McMaster-Rocketry-Team/VLF5/pcb/VLF5.kicad_pcb

## KiCad design pcb/VLF5.kicad_pcb (2025-04-10)

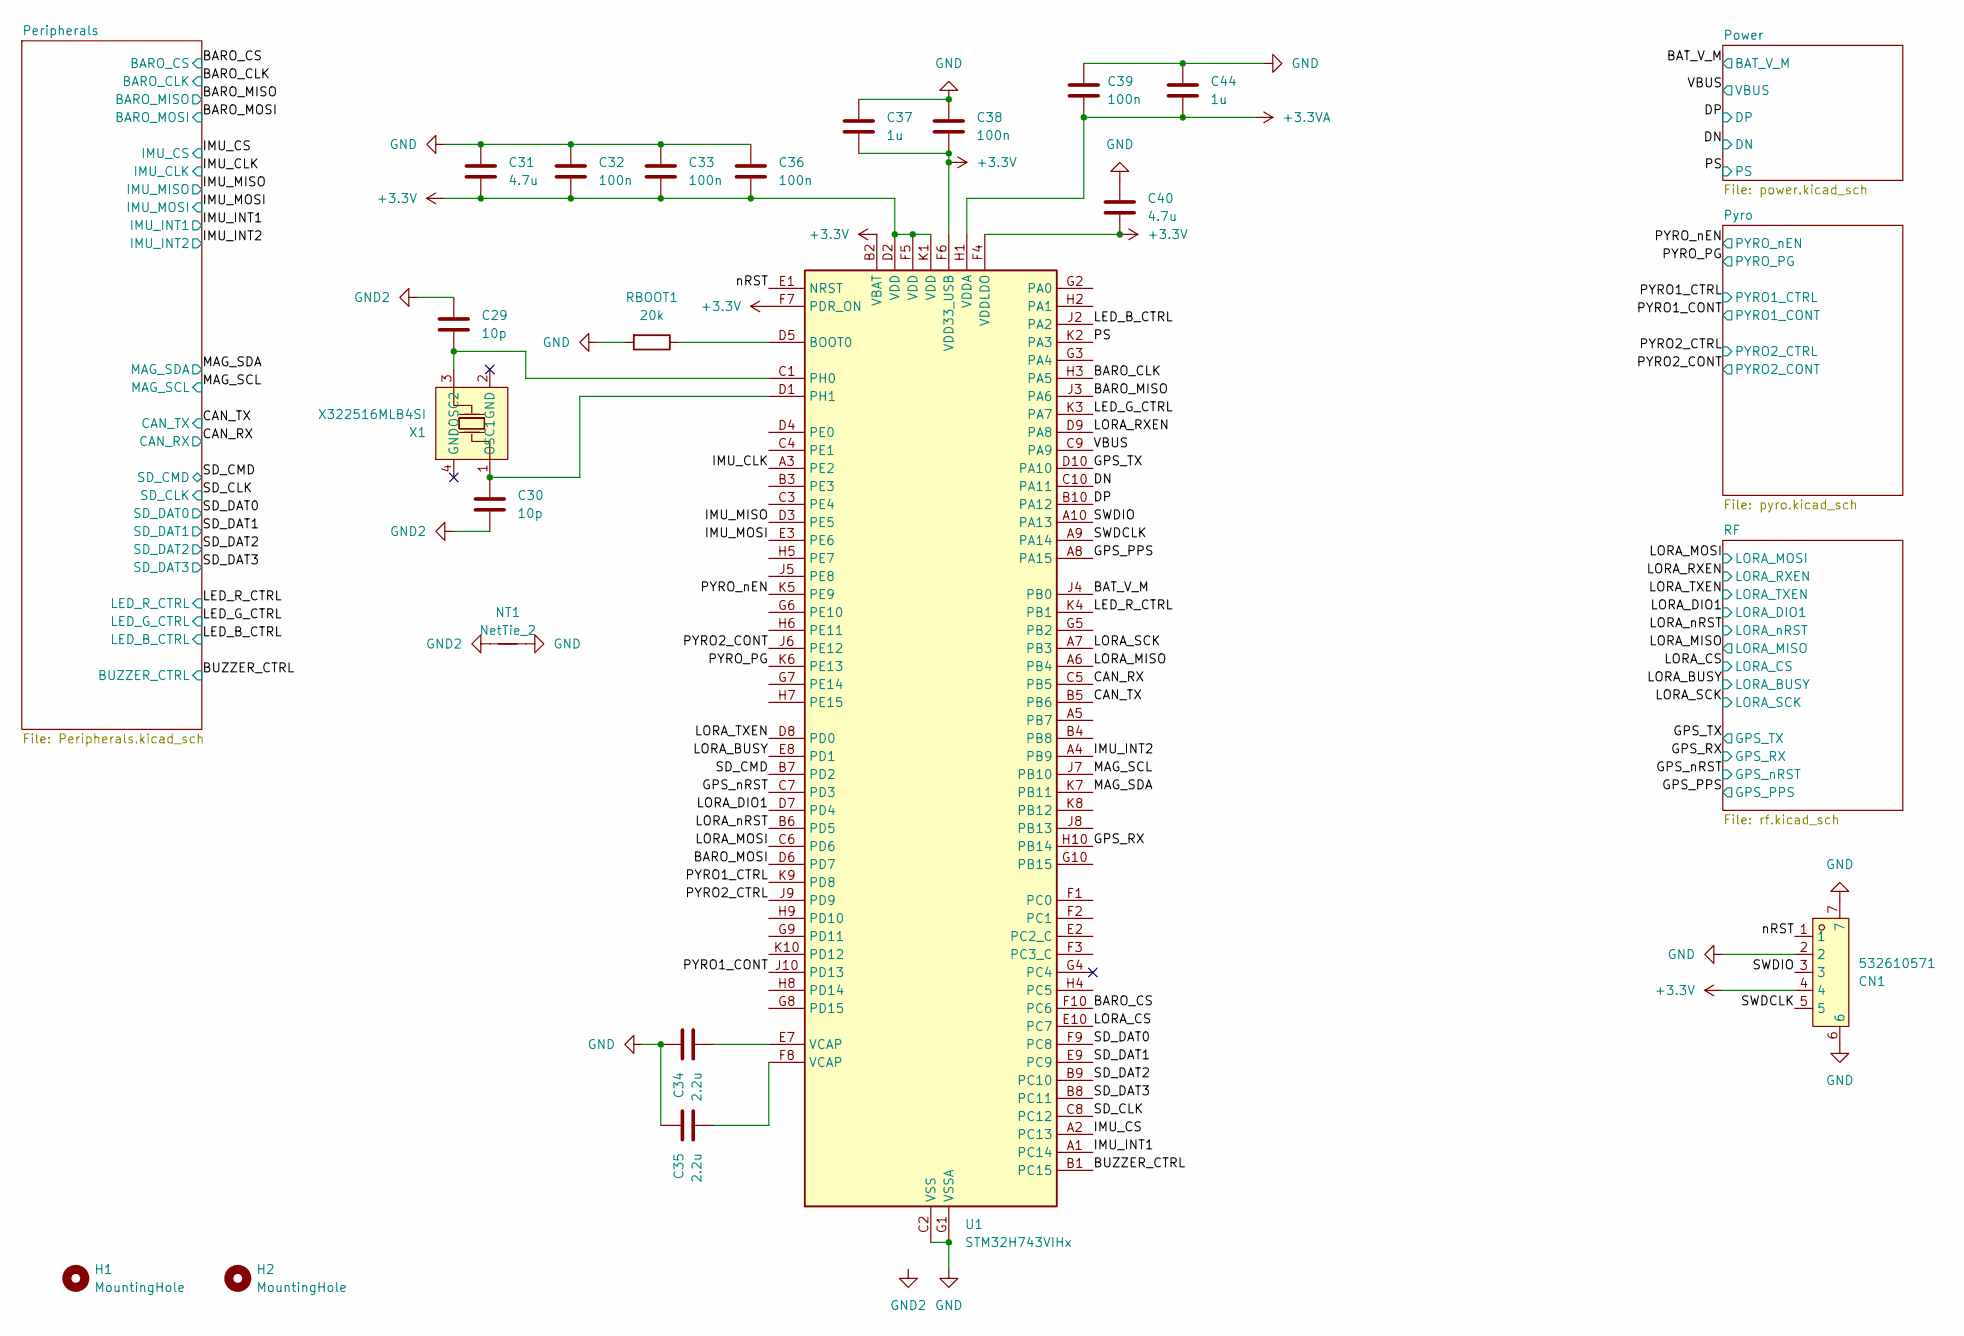
[picture p1: schematic VLF5.kicad_sch]

Parts:
C29, C30: 10p; C_0402_1005Metric
C31, C40: 4.7u; C_0402_1005Metric
C32, C33, C36, C38, C39: 100n; C_0402_1005Metric
C34, C35: 2.2u; C_0402_1005Metric
C37, C44: 1u; C_0402_1005Metric
CN1: 532610571; CONN-SMD_5P-P1.25_532610571-2; LCSC Part C392176
H1, H2: MountingHole; MountingHole_2.7mm_M2.5
NT1: NetTie_2; NetTie-2_SMD_Pad0.5mm
RBOOT1: 20k; R_0402_1005Metric
U1: STM32H743VIHx; TFBGA-100_8x8mm_Layout10x10_P0.8mm
X1: X322516MLB4SI; OSC-SMD_4P-L3.2-W2.5-BL; LCSC Part C13738

Connections:
+3.3V: C31.2, C32.2, C33.2, C36.2, C37.2, C38.2, C40.2, CN1.4, U1.B2 (VBAT), U1.D2 (VDD), U1.F4 (VDDLDO), U1.F5 (VDD), U1.F6 (VDD33_USB), U1.F7 (PDR_ON), U1.K1 (VDD); also elsewhere on the board
+3.3VA: C39.2, C44.2, U1.H1 (VDDA); also elsewhere on the board
/BARO_CLK: U1.H3 (PA5); also elsewhere on the board
/BARO_CS: U1.F10 (PC6); also elsewhere on the board
/BARO_MISO: U1.J3 (PA6); also elsewhere on the board
/BARO_MOSI: U1.D6 (PD7); also elsewhere on the board
/BAT_V_M: U1.J4 (PB0); also elsewhere on the board
/BUZZER_CTRL: U1.B1 (PC15); also elsewhere on the board
/CAN_RX: U1.C5 (PB5); also elsewhere on the board
/CAN_TX: U1.B5 (PB6); also elsewhere on the board
/DN: U1.C10 (PA11); also elsewhere on the board
/DP: U1.B10 (PA12); also elsewhere on the board
/GPS_PPS: U1.A8 (PA15); also elsewhere on the board
/GPS_RX: U1.H10 (PB14); also elsewhere on the board
/GPS_TX: U1.D10 (PA10); also elsewhere on the board
/GPS_nRST: U1.C7 (PD3); also elsewhere on the board
/IMU_CLK: U1.A3 (PE2); also elsewhere on the board
/IMU_CS: U1.A2 (PC13); also elsewhere on the board
/IMU_INT1: U1.A1 (PC14); also elsewhere on the board
/IMU_INT2: U1.A4 (PB9); also elsewhere on the board
/IMU_MISO: U1.D3 (PE5); also elsewhere on the board
/IMU_MOSI: U1.E3 (PE6); also elsewhere on the board
/LED_B_CTRL: U1.J2 (PA2); also elsewhere on the board
/LED_G_CTRL: U1.K3 (PA7); also elsewhere on the board
/LED_R_CTRL: U1.K4 (PB1); also elsewhere on the board
/LORA_BUSY: U1.E8 (PD1); also elsewhere on the board
/LORA_CS: U1.E10 (PC7); also elsewhere on the board
/LORA_DIO1: U1.D7 (PD4); also elsewhere on the board
/LORA_MISO: U1.A6 (PB4); also elsewhere on the board
/LORA_MOSI: U1.C6 (PD6); also elsewhere on the board
/LORA_RXEN: U1.D9 (PA8); also elsewhere on the board
/LORA_SCK: U1.A7 (PB3); also elsewhere on the board
/LORA_TXEN: U1.D8 (PD0); also elsewhere on the board
/LORA_nRST: U1.B6 (PD5); also elsewhere on the board
/MAG_SCL: U1.J7 (PB10); also elsewhere on the board
/MAG_SDA: U1.K7 (PB11); also elsewhere on the board
/PS: U1.K2 (PA3); also elsewhere on the board
/PYRO1_CONT: U1.J10 (PD13); also elsewhere on the board
/PYRO1_CTRL: U1.K9 (PD8); also elsewhere on the board
/PYRO2_CONT: U1.J6 (PE12); also elsewhere on the board
/PYRO2_CTRL: U1.J9 (PD9); also elsewhere on the board
/PYRO_PG: U1.K6 (PE13); also elsewhere on the board
/PYRO_nEN: U1.K5 (PE9); also elsewhere on the board
/SD_CLK: U1.C8 (PC12); also elsewhere on the board
/SD_CMD: U1.B7 (PD2); also elsewhere on the board
/SD_DAT0: U1.F9 (PC8); also elsewhere on the board
/SD_DAT1: U1.E9 (PC9); also elsewhere on the board
/SD_DAT2: U1.B9 (PC10); also elsewhere on the board
/SD_DAT3: U1.B8 (PC11); also elsewhere on the board
/SWDCLK: CN1.5, U1.A9 (PA14)
/SWDIO: CN1.3, U1.A10 (PA13)
/VBUS: U1.C9 (PA9); also elsewhere on the board
/nRST: CN1.1, U1.E1 (NRST)
unnamed: C34.2, U1.E7 (VCAP)
unnamed: C35.2, U1.F8 (VCAP)
unnamed: RBOOT1.1, U1.D5 (BOOT0)
unnamed: C29.2, U1.C1 (PH0), X1.3 (OSC2)
unnamed: C30.1, U1.D1 (PH1), X1.1 (OSC1)

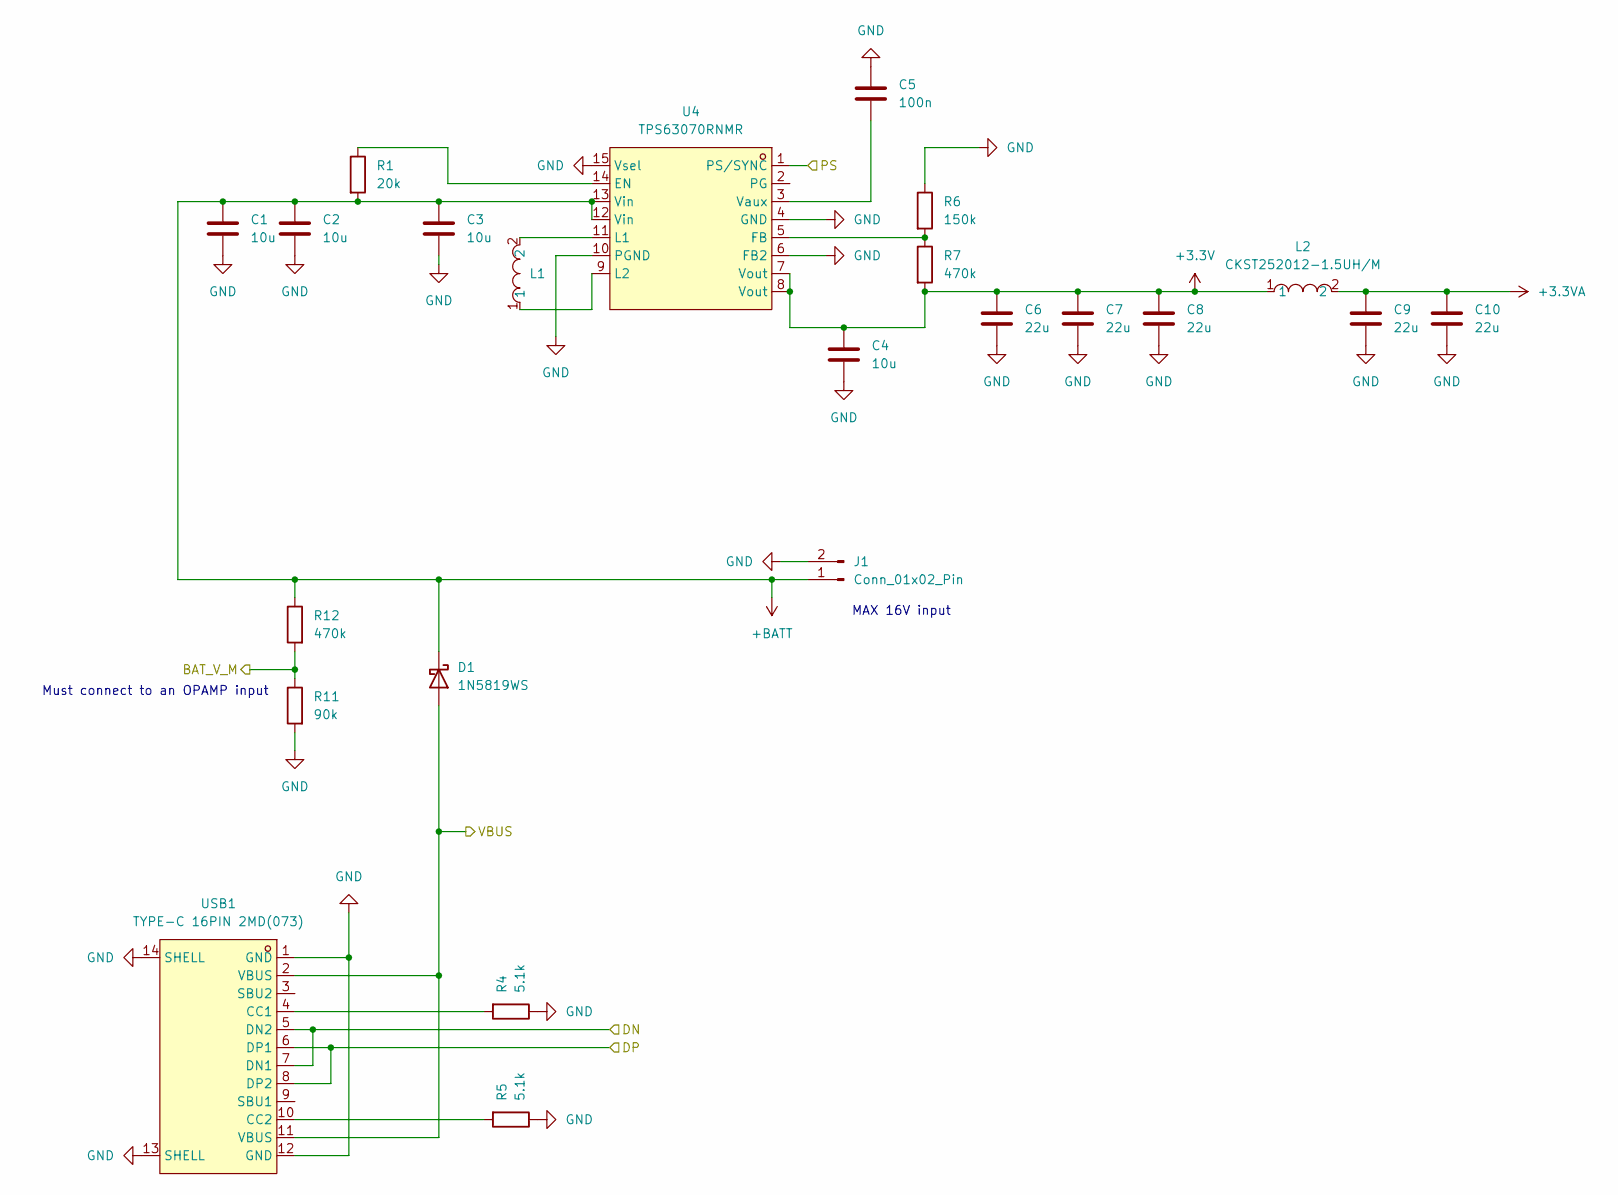
[picture p2: schematic power.kicad_sch]

Parts:
C1, C2, C3, C4: 10u; C_0603_1608Metric
C5: 100n; C_0402_1005Metric
C6, C7, C8, C9, C10: 22u; C_0603_1608Metric
D1: 1N5819WS; D_SOD-323
J1: Conn_01x02_Pin; 1054301102
L1, L2: CKST252012-1.5UH/M; IND-SMD_L2.5-W2.0-VLS252012CX-150M; LCSC Part C3002550
R1: 20k; R_0402_1005Metric
R4, R5: 5.1k; R_0402_1005Metric
R6: 150k; R_0402_1005Metric
R7, R12: 470k; R_0402_1005Metric
R11: 90k; R_0402_1005Metric
U4: TPS63070RNMR; VQFN-HR-15_L3.0-W2.5-P0.50-BL_TPS63070RNMR; LCSC Part C109322
USB1: TYPE-C 16PIN 2MD(073); USB-C-SMD_TYPE-C-6PIN-2MD-073; LCSC Part C2765186

Connections:
+3.3V: C4.2, C6.2, C7.2, C8.2, L2.1, R7.2, U4.7 (Vout), U4.8 (Vout); also elsewhere on the board
+3.3VA: C9.2, C10.2, L2.2; also elsewhere on the board
+BATT: C1.2, C2.2, C3.2, D1.1 (K), J1.1, J1.S2, R1.2, R12.1, U4.12 (Vin), U4.13 (Vin); also elsewhere on the board
/BAT_V_M: R11.1, R12.2; also elsewhere on the board
/DN: USB1.5 (DN2), USB1.7 (DN1); also elsewhere on the board
/DP: USB1.6 (DP1), USB1.8 (DP2); also elsewhere on the board
/PS: U4.1 (PS/SYNC); also elsewhere on the board
/VBUS: D1.2 (A), USB1.2 (VBUS), USB1.11 (VBUS); also elsewhere on the board
unnamed: R1.1, U4.14 (EN)
unnamed: R6.2, R7.1, U4.5 (FB)
unnamed: L1.2, U4.11 (L1)
unnamed: L1.1, U4.9 (L2)
unnamed: C5.1, U4.3 (Vaux)
unnamed: R4.2, USB1.4 (CC1)
unnamed: R5.2, USB1.10 (CC2)

Notes on the sheet:
Must connect to an OPAMP input
MAX 16V input

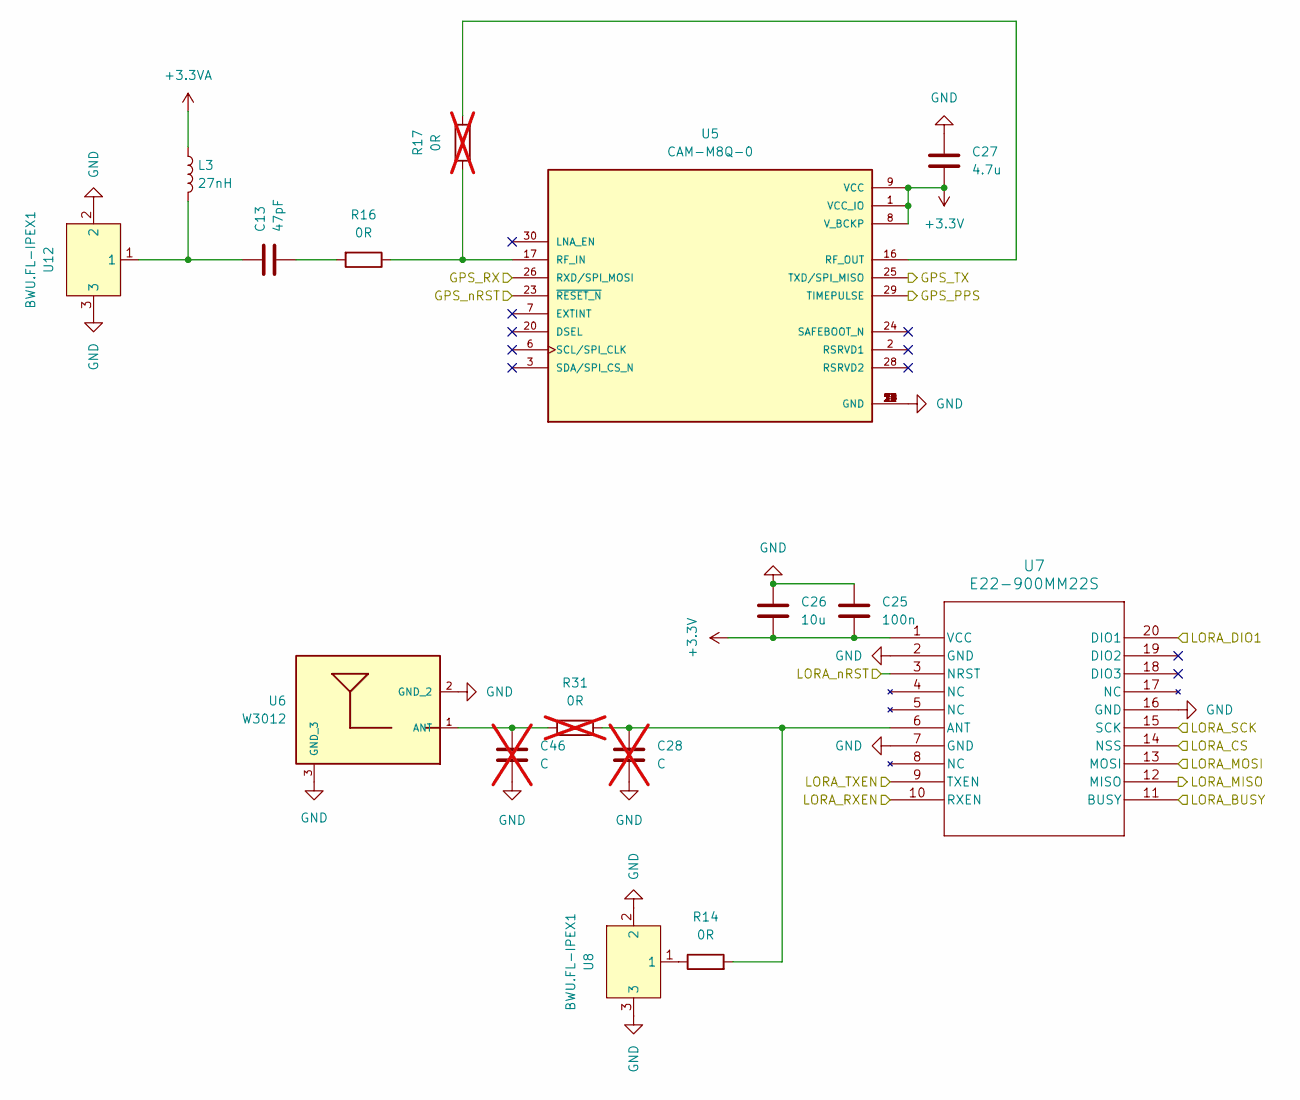
[picture p3: schematic rf.kicad_sch]

Parts:
C13: 47pF; C_0603_1608Metric_Pad1.08x0.95mm_HandSolder
C25: 100n; C_0402_1005Metric
C26: 10u; C_0603_1608Metric
C27: 4.7u; C_0402_1005Metric
C28, C46: C; C_0603_1608Metric_Pad1.08x0.95mm_HandSolder; not fitted
L3: 27nH; L_0603_1608Metric_Pad1.05x0.95mm_HandSolder
R14, R16: 0R; R_0603_1608Metric_Pad0.98x0.95mm_HandSolder
R17, R31: 0R; R_0603_1608Metric_Pad0.98x0.95mm_HandSolder; not fitted
U5: CAM-M8Q-0; LCC100P960X1400X210-31N
U6: W3012; W3012-ANT-PKG
U7: E22-900MM22S; E22-900MM22S_BYT
U8, U12: BWU.FL-IPEX1; IPEX-SMD_BWIPX-1-001E; LCSC Part C5137195

Connections:
+3.3V: C25.2, C26.2, C27.2, U5.1 (VCC_IO), U5.8 (V_BCKP), U5.9 (VCC), U7.1 (VCC); also elsewhere on the board
+3.3VA: L3.1; also elsewhere on the board
/GPS_PPS: U5.29 (TIMEPULSE); also elsewhere on the board
/GPS_RX: U5.26 (RXD/SPI_MOSI); also elsewhere on the board
/GPS_TX: U5.25 (TXD/SPI_MISO); also elsewhere on the board
/GPS_nRST: U5.23 (~RESET_N); also elsewhere on the board
/LORA_BUSY: U7.11 (BUSY); also elsewhere on the board
/LORA_CS: U7.14 (NSS); also elsewhere on the board
/LORA_DIO1: U7.20 (DIO1); also elsewhere on the board
/LORA_MISO: U7.12 (MISO); also elsewhere on the board
/LORA_MOSI: U7.13 (MOSI); also elsewhere on the board
/LORA_RXEN: U7.10 (RXEN); also elsewhere on the board
/LORA_SCK: U7.15 (SCK); also elsewhere on the board
/LORA_TXEN: U7.9 (TXEN); also elsewhere on the board
/LORA_nRST: U7.3 (NRST); also elsewhere on the board
unnamed: C13.1, L3.2, U12.1
unnamed: C13.2, R16.2
unnamed: R14.1, U8.1
unnamed: R16.1, R17.1, U5.17 (RF_IN)
unnamed: R17.2, U5.16 (RF_OUT)
unnamed: C46.1, R31.1, U6.1 (ANT)
unnamed: C28.1, R14.2, R31.2, U7.6 (ANT)

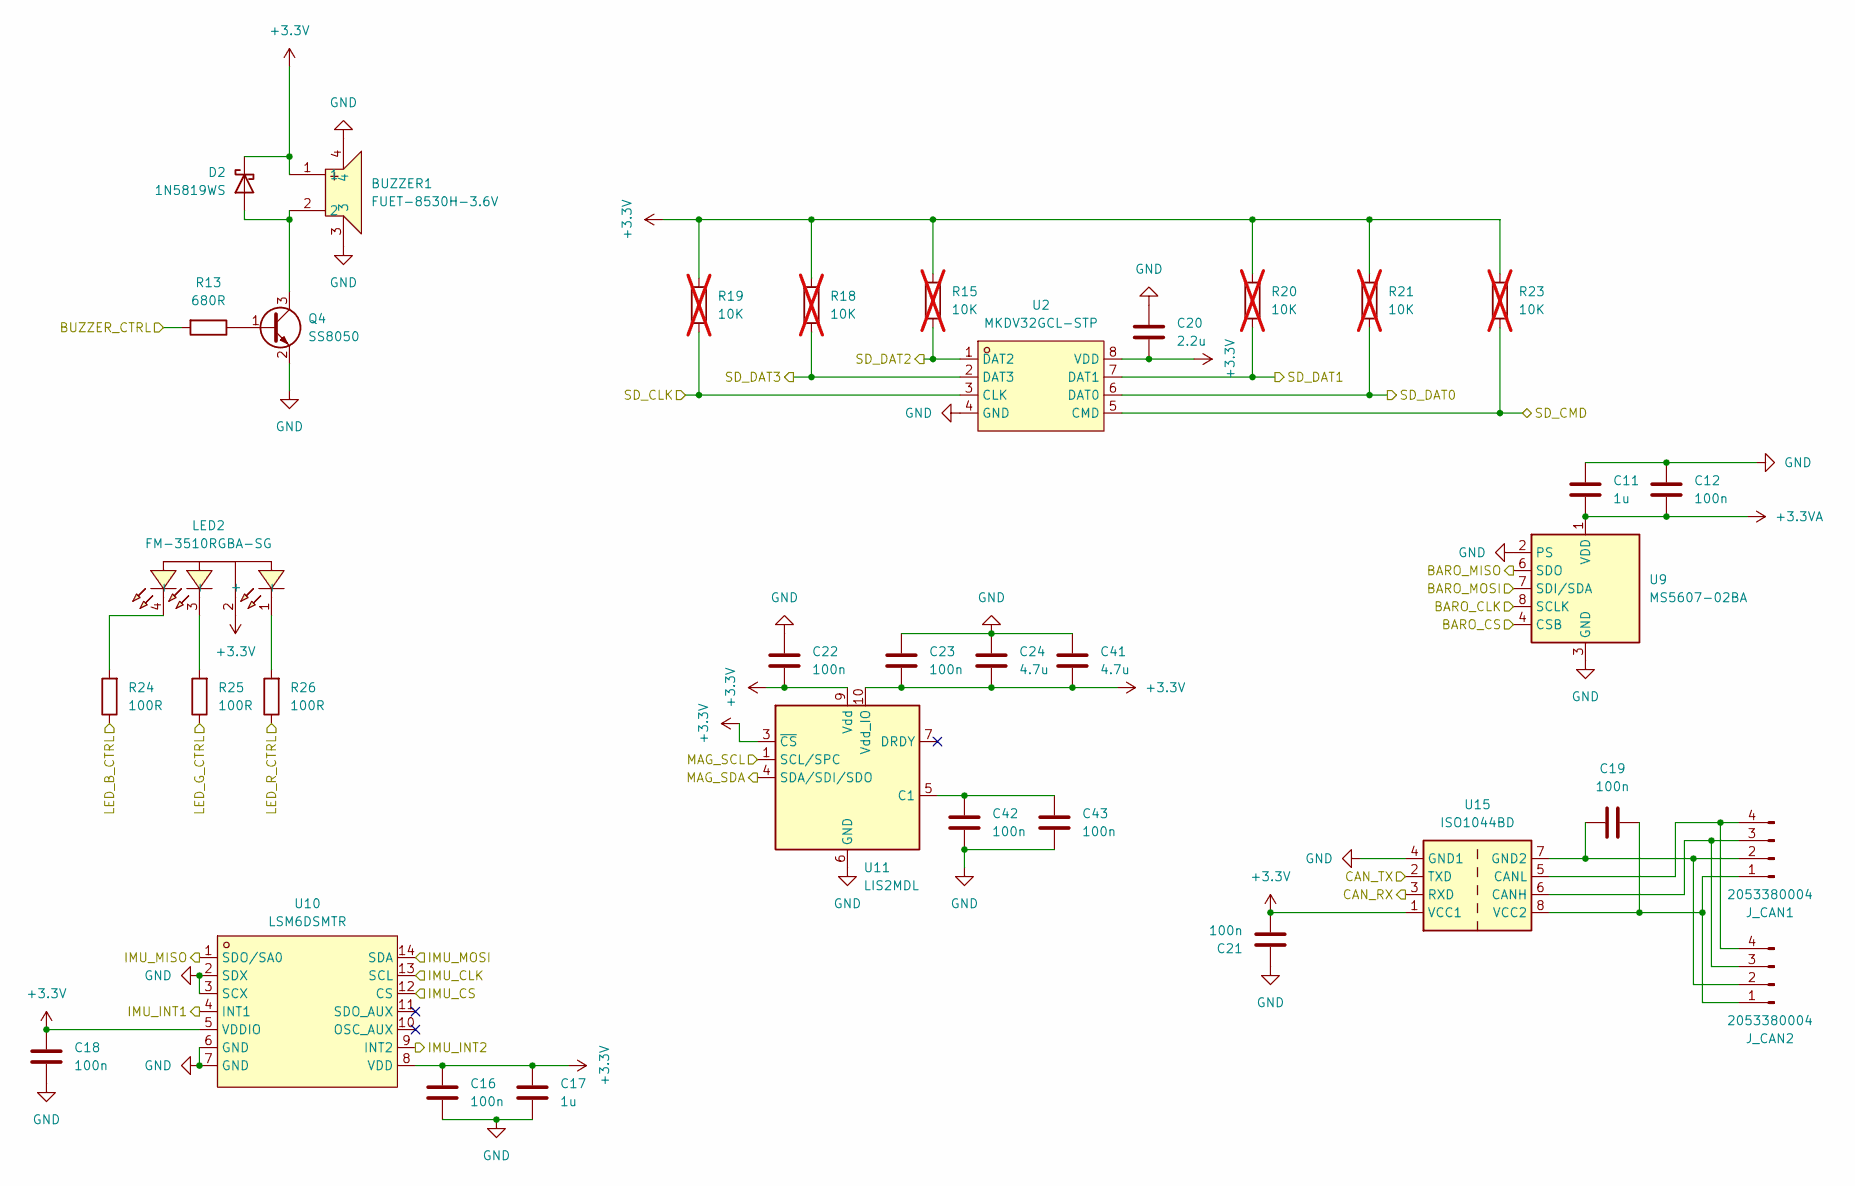
[picture p4: schematic Peripherals.kicad_sch]

Parts:
BUZZER1: FUET-8530H-3.6V; BUZ-SMD_4P-L8.5-W8.5_FUET-8530-05; LCSC Part C417429
C11, C17: 1u; C_0402_1005Metric
C12, C16, C18, C19, C21, C22, C23, C42, C43: 100n; C_0402_1005Metric
C20: 2.2u; C_0402_1005Metric
C24, C41: 4.7u; C_0402_1005Metric
D2: 1N5819WS; D_SOD-323
J_CAN1, J_CAN2: 2053380004; CONN_2053380000-SD_04_MOL
LED2: FM-3510RGBA-SG; LED-SMD_FM-3510RGBA-SG; LCSC Part C727903
Q4: SS8050; SOT-23
R13: 680R; R_0402_1005Metric
R15, R18, R19, R20, R21, R23: 10K; R_0603_1608Metric_Pad0.98x0.95mm_HandSolder; not fitted
R24, R25, R26: 100R; R_0402_1005Metric
U2: MKDV32GCL-STP; LGA-8_L6.0-W8.0-P1.27-TL; LCSC Part C7500179
U9: MS5607-02BA; LGA-8_3x5mm_P1.25mm
U10: LSM6DSMTR; LGA-14_L3.0-W2.5-P0.50-TL; LCSC Part C94048
U11: LIS2MDL; LGA-12_2x2mm_P0.5mm
U15: ISO1044BD; SOIC-8_3.9x4.9mm_P1.27mm

Connections:
+3.3V: BUZZER1.1, C16.1, C17.1, C18.1, C20.2, C21.2, C22.2, C23.2, C24.2, C41.2, D2.1 (K), LED2.2 (+), R15.2, R18.2, R19.2, R20.2, R21.2, R23.2, U2.8 (VDD), U10.5 (VDDIO), U10.8 (VDD), U11.3 (~CS), U11.9 (Vdd), U11.10 (Vdd_IO), U15.1 (VCC1); also elsewhere on the board
+3.3VA: C11.2, C12.2, U9.1 (VDD); also elsewhere on the board
/BARO_CLK: U9.8 (SCLK); also elsewhere on the board
/BARO_CS: U9.4 (CSB), U9.5 (CSB); also elsewhere on the board
/BARO_MISO: U9.6 (SDO); also elsewhere on the board
/BARO_MOSI: U9.7 (SDI/SDA); also elsewhere on the board
/BUZZER_CTRL: R13.2; also elsewhere on the board
/CAN_RX: U15.3 (RXD); also elsewhere on the board
/CAN_TX: U15.2 (TXD); also elsewhere on the board
/IMU_CLK: U10.13 (SCL); also elsewhere on the board
/IMU_CS: U10.12 (CS); also elsewhere on the board
/IMU_INT1: U10.4 (INT1); also elsewhere on the board
/IMU_INT2: U10.9 (INT2); also elsewhere on the board
/IMU_MISO: U10.1 (SDO/SA0); also elsewhere on the board
/IMU_MOSI: U10.14 (SDA); also elsewhere on the board
/LED_B_CTRL: R24.1; also elsewhere on the board
/LED_G_CTRL: R25.1; also elsewhere on the board
/LED_R_CTRL: R26.1; also elsewhere on the board
/MAG_SCL: U11.1 (SCL/SPC); also elsewhere on the board
/MAG_SDA: U11.4 (SDA/SDI/SDO); also elsewhere on the board
/SD_CLK: R19.1, U2.3 (CLK); also elsewhere on the board
/SD_CMD: R23.1, U2.5 (CMD); also elsewhere on the board
/SD_DAT0: R21.1, U2.6 (DAT0); also elsewhere on the board
/SD_DAT1: R20.1, U2.7 (DAT1); also elsewhere on the board
/SD_DAT2: R15.1, U2.1 (DAT2); also elsewhere on the board
/SD_DAT3: R18.1, U2.2 (DAT3); also elsewhere on the board
unnamed: BUZZER1.2, D2.2 (A), Q4.3 (C)
unnamed: C19.2, J_CAN1.1, J_CAN2.1, U15.8 (VCC2)
unnamed: C19.1, J_CAN1.2, J_CAN2.2, U15.7 (GND2)
unnamed: J_CAN1.3, J_CAN2.3, U15.6 (CANH)
unnamed: J_CAN1.4, J_CAN2.4, U15.5 (CANL)
unnamed 65: J_CAN1.6, J_CAN2.5; also elsewhere on the board
unnamed: LED2.1 (-), R26.2
unnamed: LED2.3 (-), R25.2
unnamed: LED2.4 (-), R24.2
unnamed: Q4.1 (B), R13.1
unnamed: C42.1, C43.1, U11.5 (C1)

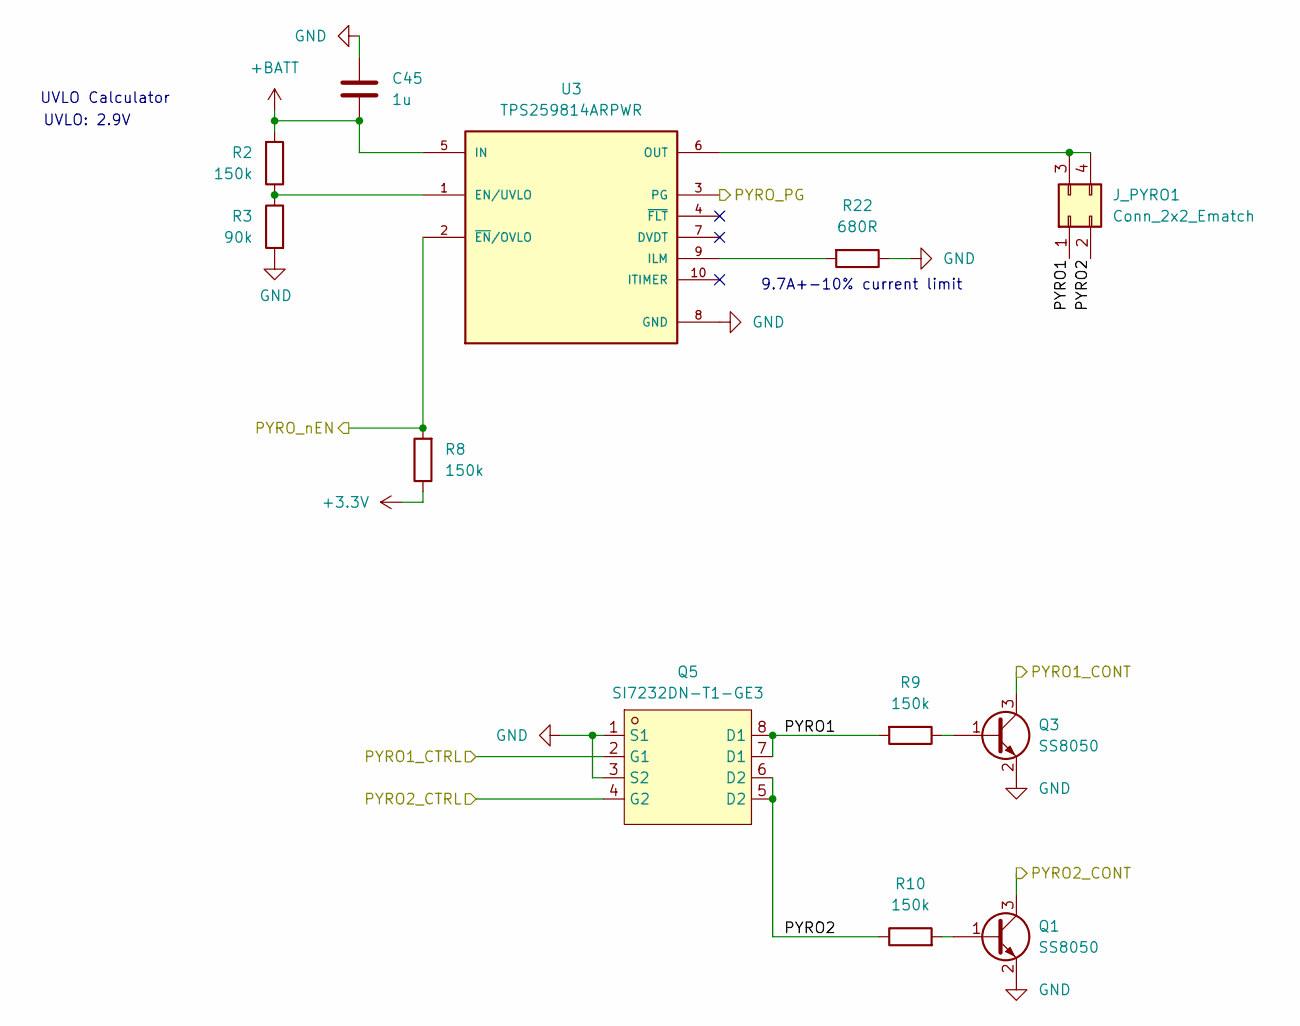
[picture p5: schematic pyro.kicad_sch]

Parts:
C45: 1u; C_0402_1005Metric
J_PYRO1: Conn_2x2_Ematch; 1054051104
Q1, Q3: SS8050; SOT-23
Q5: SI7232DN-T1-GE3; POWER-1212-8_L3.3-W3.3-P0.66-LS3.3-BL; LCSC Part C144854
R2, R8, R9, R10: 150k; R_0402_1005Metric
R3: 90k; R_0402_1005Metric
R22: 680R; R_0402_1005Metric
U3: TPS259814ARPWR; IC_TPS259814ARPWR; PARTREV A

Connections:
+3.3V: R8.1; also elsewhere on the board
+BATT: C45.2, R2.2, U3.5 (IN); also elsewhere on the board
/PYRO1_CONT: Q3.3 (C); also elsewhere on the board
/PYRO1_CTRL: Q5.2 (G1); also elsewhere on the board
/PYRO2_CONT: Q1.3 (C); also elsewhere on the board
/PYRO2_CTRL: Q5.4 (G2); also elsewhere on the board
/PYRO_PG: U3.3 (PG); also elsewhere on the board
/PYRO_nEN: R8.2, U3.2 (~EN/OVLO); also elsewhere on the board
/Pyro/PYRO1: J_PYRO1.1, Q5.7 (D1), Q5.8 (D1), R9.2
/Pyro/PYRO2: J_PYRO1.2, Q5.5 (D2), Q5.6 (D2), R10.1
unnamed 65: J_PYRO1.3, J_PYRO1.4, J_PYRO1.S1, U3.6 (OUT); also elsewhere on the board
unnamed: Q1.1 (B), R10.2
unnamed: Q3.1 (B), R9.1
unnamed: R2.1, R3.1, U3.1 (EN/UVLO)
unnamed: R22.2, U3.9 (ILM)

Notes on the sheet:
9.7A+-10% current limit
UVLO Calculator
UVLO: 2.9V

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
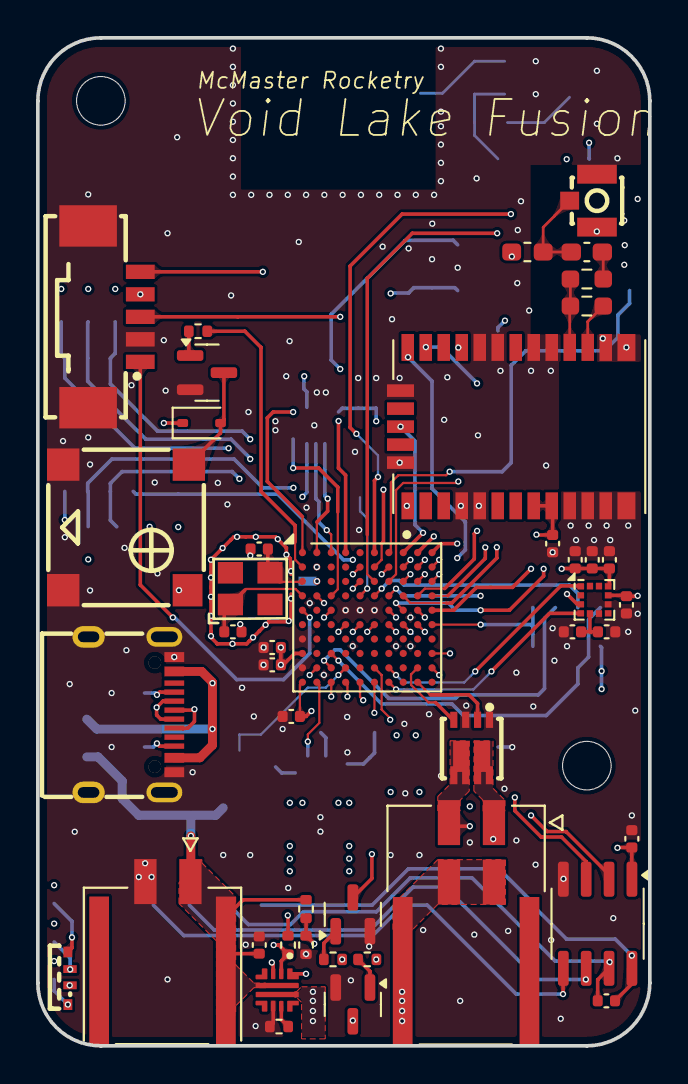
[picture p6: board VLF5.kicad_pcb from above]

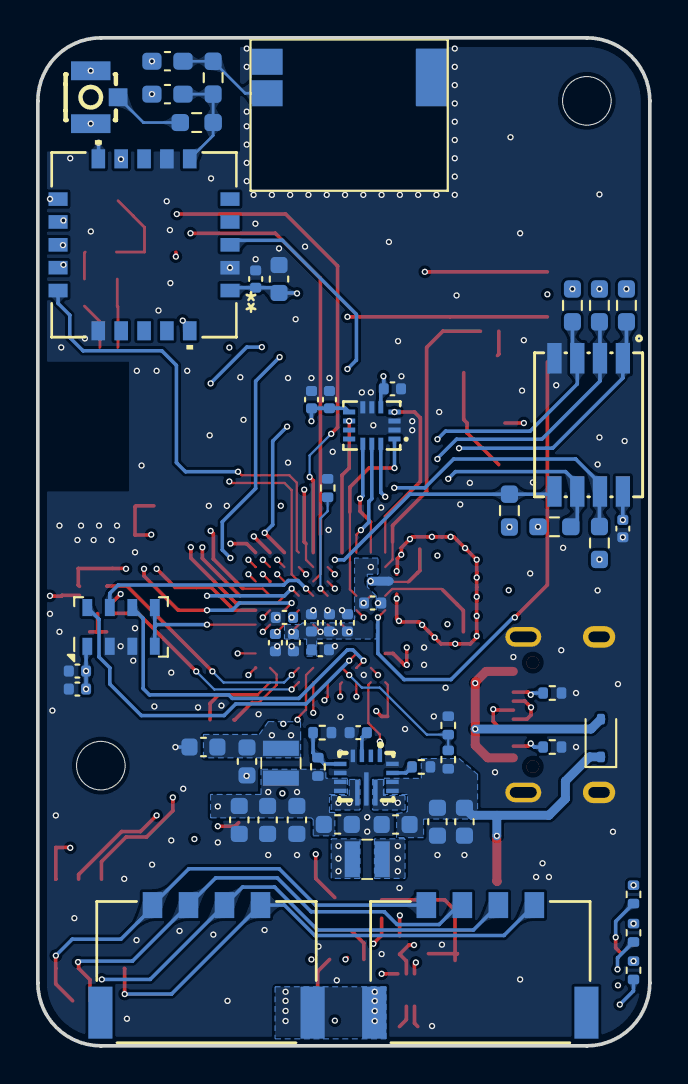
[picture p7: board VLF5.kicad_pcb from below]

Board: 6 copper layers, 34.0 x 56.0 mm, 105 parts (59 on the bottom side), 92 nets.
