McMaster-Rocketry-Team/VLF5/cubemx/cubemx.ioc

Mcu.UserName=STM32H742VIHx
PA10.Signal=USART1_RX
PA11.Signal=USB_OTG_FS_DM
PA12.Signal=USB_OTG_FS_DP
PA5.Signal=SPI1_SCK
PA6.Signal=SPI1_MISO
PA9.Signal=USB_OTG_FS_VBUS
PB0.Signal=OPAMP1_VINP
PB10.Signal=I2C2_SCL
PB11.Signal=I2C2_SDA
PB14.Signal=USART1_TX
PB5.Signal=FDCAN2_RX
PB6.Signal=FDCAN2_TX
PB9.Signal=GPXTI9
PC10.Signal=SDMMC1_D2
PC11.Signal=SDMMC1_D3
PC12.Signal=SDMMC1_CK
PC4.Signal=OPAMP1_VOUT
PC8.Signal=SDMMC1_D0
PC9.Signal=SDMMC1_D1
PD12.Signal=GPXTI12
PD13.Signal=GPXTI13
PD2.Signal=SDMMC1_CMD
PD6.Signal=SPI3_MOSI
PD7.Signal=SPI1_MOSI
PE2.Signal=SPI4_SCK
PE5.Signal=SPI4_MISO
PE6.Signal=SPI4_MOSI
