McMaster-Rocketry-Team/VLF5/firmware/src/low_power_mode.rs

use core::cell::RefCell;

use embassy_futures::{join::join3, select::select};
use embassy_sync::{
    blocking_mutex::Mutex as BlockingMutex,
    blocking_mutex::raw::{CriticalSectionRawMutex, NoopRawMutex},
    watch::{self, Watch},
};
use embassy_time::{Duration, Ticker};
use firmware_common_new::{
    can_bus::{
        messages::{CanBusMessageEnum, vl_status::FlightStage},
        node_types::AMP_NODE_TYPE,
    },
    gps::GPSData,
    readings::BaroData,
    sensor_reading::SensorReading,
    time::BootTimestamp,
    vlp::{client::VLPAvionics, packets::low_power_telemetry::LowPowerTelemetryPacketBuilder},
};

use crate::{avionics_mode::AvionicsMode, can::CanReceiverSub, can_central::CanCentral};

pub async fn low_power_mode(
    vlp_avionics_client: &'static VLPAvionics<NoopRawMutex>,
    avionics_mode: &'static Watch<CriticalSectionRawMutex, AvionicsMode, 10>,
    can_central: &'static CanCentral<NoopRawMutex>,
    mut gps_reading: watch::DynReceiver<'static, SensorReading<BootTimestamp, GPSData>>,
    mut battery_v_reading: watch::DynReceiver<'static, SensorReading<BootTimestamp, f32>>,
    mut baro_reading: watch::DynReceiver<'static, SensorReading<BootTimestamp, BaroData>>,
    mut can_receiver_sub: CanReceiverSub,
    flight_stage: &'static BlockingMutex<NoopRawMutex, RefCell<FlightStage>>,
) {
    flight_stage.lock(|r| {
        *r.borrow_mut() = FlightStage::LowPower;
    });

    let packet_builder = LowPowerTelemetryPacketBuilder::<NoopRawMutex>::new();

    let update_packet_sensor_fut = async {
        let mut ticker = Ticker::every(Duration::from_hz(1));
        gps_reading.get().await;
        battery_v_reading.get().await;
        baro_reading.get().await;
        loop {
            let gps_data = gps_reading.try_get().unwrap().data;
            let battery_v = battery_v_reading.try_get().unwrap().data;
            let baro_data = baro_reading.try_get().unwrap().data;
            packet_builder.update(|packet| {
                packet.num_of_fix_satellites = gps_data.num_of_fix_satellites;
                packet.gps_fixed = gps_data.lat_lon.is_some();
                packet.vl_battery_v = battery_v;
                packet.air_temperature = baro_data.temperature;
                packet.amp_online = can_central
                    .get_nodes::<1>(AMP_NODE_TYPE)
                    .first()
                    .map(|node| node.is_online())
                    .unwrap_or(false)
            });

            ticker.next().await;
        }
    };

    let update_packet_can_fut = async {
        loop {
            let message = can_receiver_sub.next_message_pure().await.data.message;
            match message {
                CanBusMessageEnum::AmpStatus(message) => {
                    packet_builder.update(|packet| {
                        packet.shared_battery_v = message.shared_battery_mv as f32 / 1000.0;
                    });
                }
                _ => {}
            }
        }
    };

    let send_packet_fut = async {
        let mut ticker = Ticker::every(Duration::from_hz(5));

        loop {
            ticker.next().await;

            vlp_avionics_client.send(packet_builder.create_packet().into());
        }
    };

    let fut = join3(
        update_packet_sensor_fut,
        update_packet_can_fut,
        send_packet_fut,
    );

    let wait_low_power_mode_end_fut = async {
        let mut receiver = avionics_mode.receiver().unwrap();
        receiver.changed_and(|m| *m != AvionicsMode::LowPower).await;
    };

    select(fut, wait_low_power_mode_end_fut).await;
}
