McMaster-Rocketry-Team/VLF5/firmware/src/avionics_mode.rs

#[derive(Clone, Copy, defmt::Format, PartialEq, Eq)]
pub enum AvionicsMode {
    Armed,
    SelfTest,
    LowPower,
    Landed,
    Demo,
}

impl From<firmware_common_new::vlp::packets::change_mode::Mode> for AvionicsMode {
    fn from(value: firmware_common_new::vlp::packets::change_mode::Mode) -> Self {
        match value {
            firmware_common_new::vlp::packets::change_mode::Mode::LowPower => AvionicsMode::LowPower,
            firmware_common_new::vlp::packets::change_mode::Mode::SelfTest => AvionicsMode::SelfTest,
            firmware_common_new::vlp::packets::change_mode::Mode::Armed => AvionicsMode::Armed,
            firmware_common_new::vlp::packets::change_mode::Mode::Landed => AvionicsMode::Landed,
            firmware_common_new::vlp::packets::change_mode::Mode::Demo => AvionicsMode::Demo,
        }
    }
}
