McMaster-Rocketry-Team/VLF5/firmware/src/tasks/buzzer_task.rs

use embassy_stm32::{
    gpio::{Level, Output, Speed},
    peripherals::PC15,
    Peri,
};
use embassy_sync::{blocking_mutex::raw::CriticalSectionRawMutex, pubsub::PubSubChannel};
use embassy_time::{Duration, Ticker, Timer};

/// Set to `true` to silence the buzzer (messages are still drained).
pub const DISABLE_BUZZER: bool = false;

#[derive(Debug, Clone, PartialEq, Eq)]
pub enum BuzzerTone {
    Low(
        /// Duration
        u32,
        /// Silent duration
        u32,
    ),
    Mid(
        /// Duration
        u32,
        /// Silent duration
        u32,
    ),
    High(
        /// Duration
        u32,
        /// Silent duration
        u32,
    ),
}

pub type BuzzerPubSub = PubSubChannel<CriticalSectionRawMutex, BuzzerTone, 10, 1, 1>;

#[embassy_executor::task]
pub async fn buzzer_task(
    buzzer_ctrl: Peri<'static, PC15>,
    buzzer_pubsub: &'static BuzzerPubSub,
) {
    let mut sub = buzzer_pubsub.subscriber().unwrap();
    let mut buzzer_ctrl = Output::new(buzzer_ctrl, Level::Low, Speed::Low);

    loop {
        let tone = sub.next_message_pure().await;
        if DISABLE_BUZZER {
            continue;
        }

        let (frequency, duration, silent_duration) = match tone {
            BuzzerTone::Low(duration, silent_duration) => (2600, duration, silent_duration),
            BuzzerTone::Mid(duration, silent_duration) => (2800, duration, silent_duration),
            BuzzerTone::High(duration, silent_duration) => (3000, duration, silent_duration),
        };

        let mut ticker = Ticker::every(Duration::from_hz(frequency as u64 * 2));
        for _ in 0..(frequency * duration / 1000) {
            buzzer_ctrl.set_high();
            ticker.next().await;
            buzzer_ctrl.set_low();
            ticker.next().await;
        }
        Timer::after(Duration::from_millis(silent_duration as u64)).await;
    }
}
