McMaster-Rocketry-Team/VLF5/firmware/src/tasks/mod.rs

pub mod exti15_10_irqs;
pub mod buzzer_task;
pub mod pyro_task;
pub mod vlp_avionics_daemon_task;
pub mod gps_task;
pub mod sensor_tasks;
pub mod unix_clock;
pub mod amp_control_task;
pub mod data_logger;
pub mod sd_card_writer;
