McMaster-Rocketry-Team/VLF5/(commit log)

2025-03-19 added active gps antenna connector
    [Peripherals.kicad_sch, VLF5.kicad_pcb, rf.kicad_sch]
2025-03-21 add pull up resistor for sd, change pad net
    [Peripherals.kicad_sch, VLF5.kicad_pcb, VLF5.kicad_sch, rf.kicad_sch]
2025-03-31 Original Layout with Pins Configured
    🙏
    [Peripherals.kicad_sch, VLF5.kicad_pcb, VLF5.kicad_sch, power.kicad_sch, pyro.kicad_sch, rf.kicad_sch]
2025-03-31 Playing with configs Template
    As title describes
    [VLF5.kicad_pcb]
2025-04-01 Iterating
    Iterating
    [VLF5.kicad_pcb, VLF5.kicad_sch]
2025-04-01 Changed Pins new Layout
    Changed Pins new Layout
    [VLF5.kicad_pcb, VLF5.kicad_sch]
2025-04-01 Playing with Trace Configurations
    Still WIP!
    [VLF5.kicad_pcb]
2025-04-07 Saving for Edits
    [VLF5.kicad_pcb]
2025-04-07 Potential Layout 1
    - LDO in place?
    [VLF5.kicad_pcb]
2025-04-08 More Progress
    - Decoupling Capacitors Layed out
    - GPIO pins changed around for GPS and LoRa
    - STM Pin Vias Placed
    WARNING: ALTERED NO-NET PADS KEEP RESETTING TO NO-NET ENSURE NO ERRORS IN DRC.
    [VLF5.kicad_pcb, VLF5.kicad_sch]
2025-04-09 Committing Current Progress just in case
    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
    [VLF5.kicad_pcb]
2025-04-10 More Routing
    Saving in case
    [VLF5.kicad_pcb]
2025-04-10 Playing with routing paths
    almost there
    [VLF5.kicad_pcb]
2025-04-10 About to change pins saving
    oh boy
    [VLF5.kicad_pcb]
2025-04-10 VLF5 Rough Finish
    Hallelujah
    [VLF5.kicad_pcb, VLF5.kicad_sch]
2025-05-05 imu and baro test
2025-05-09 imu noise test
2025-06-24 buzzer task and pyro task
    [buzzer_task.rs, pyro_task.rs]
2025-07-13 fix compile errors, fire pyro option
    [main_gcm.rs]
2025-07-25 low power mode
2025-07-25 refactor can bus
2025-08-09 update imu driver
2025-08-10 imu test
2025-08-11 imu baro task
2025-08-12 update can bus
2025-08-19 stop camera after 15 min
2026-07-08 Add SD flight logging and USB download to main avionics firmware.
    Integrates IMU-clocked data logging, crash-resilient SD writes with periodic flush, and WinUSB bulk download into main.rs for long-duration flights.
    [data_logger.rs, gps_task.rs, main.rs, mod.rs, sd_card_writer.rs, usb_handler.rs, utils.rs]
2026-07-08 Upgrade VLF5 firmware to latest Embassy and harden SD flight logging.
    Remove the unused bootloader crate, migrate to upstream Embassy with updated
    peripheral bindings, and improve SD writes with a decoupled queue, I/O timeouts,
    and offline isolation so a dead card cannot block avionics. Add SD benchmarks,
    duration test scripts, and a udev rule for rocket-cli USB access.
    [can.rs, clock_config.rs, data_logger.rs, main.rs, main_gcm.rs, main_sd_test.rs]
2026-07-08 Split flight logging into tagged IMU and SLOW streams for v2 storage.
    Emit high-rate IMU samples every tick and SLOW snapshots on change or heartbeat, and update the SD writer for variable-length tagged records with v2 superblock resume.
2026-07-09 Log airbrakes extension, handle full SD card, and add DISABLE_BUZZER.
    Wire commanded/actual airbrakes into SLOW flight records, stop logging when the card is full while keeping USB access, and gate all buzzer output behind a compile-time flag.
    [armed_mode.rs, buzzer_task.rs, can.rs, data_logger.rs, demo_mode.rs, main.rs, sd_card_writer.rs]
2026-07-09 Add in-process HIL dual/single plots and persist target apogee on SD.
    Fake sensors and VLP drive end-to-end armed-mode tests on hardware; document the plots in HIL.md and raise watch/pubsub capacity so Armed no longer panics at boot.
    [armed_mode.rs, buzzer_task.rs, main.rs, mod.rs, pyro_task.rs, receive_vlp_task.rs, sd_card_writer.rs, sensor_replay.rs]
2026-07-09 HIL Option-B: keep real LoRa in the loop, measured-noise baro replay
    Decouple the `hil-replay` feature from the radio so HIL builds command the
    rocket over the air via the GCM + rocket-cli, exercising the full VLP path
    (signing, ack, mode changes) instead of an on-device scripted uplink bridge.
    - Ungate the real `vlp_avionics_daemon_task` (+ VLP_KEY / LORA_CONFIG / imports)
    so it runs in every build; delete the on-device HIL LoRa bridge/script.
    - Remove `src/hil/vlp_script.rs` and its module decl. Sensors, GPS, and pyro
    GPIO stay faked under `hil-replay` (bench-safe, no e-matches).
    - Rewrite the baro generator: `trajectory_altitude_asl` (pad -> burn -> coast ->
    terminal descent), dete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
    [main.rs, main_baro_bench.rs, mod.rs, sensor_replay.rs]
2026-07-09 HIL: correct boot warning to say the LoRa radio is real
    Option-B keeps the real radio in HIL builds; the boot warning still said
    "fake sensors/VLP". Update it to "fake sensors/GPS + no pyro GPIO, REAL LoRa
    radio" so the operator reading RTT isn't misled.
    [main.rs]
2026-07-09 HIL: bridge VLP over USB instead of LoRa
    HIL builds now run the full VLP path over the VLF5's own USB, so a bench needs no
    GCM and no radio link. The `usb_handler` adds (under `hil-replay`):
    - a second bulk-IN endpoint (EP2) that streams each VLP downlink the avionics app
    emits as a fixed 101-byte `[len][payload]` frame, and
    - a `CliRequest::Uplink` control-OUT path whose data stage carries a serialized
    uplink, queued to a bridge task that `inject_uplink`s it into the VLP client.
    Both loops run in the low-prio executor alongside the flight-log drain, sharing the
    same `vlp_avionics_client` (NoopRawMutex-safe). The real LoRa daemon (and VLP_KEY /
    LORA_CONFIG / SX126x peripherals) are gate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
    [main.rs, usb_handler.rs]
2026-07-09 HIL: document the USB-VLP bench workflow + add operator harness
    HIL_BENCH.md: new section 0 documenting the working end-to-end path — VLP over the
    VLF5's own USB (no GCM, no radio), with the exact flash/control commands and the wire
    protocol (EP2 bulk-IN downlink frames + CliRequest::Uplink control-OUT).
    hil_operator.py: the driver used to verify it — walks the single-deploy operator
    sequence over `rocket-cli control --usb` (target-apogee, self-test, arm) and asserts
    the flight (stages, apogee, airbrakes, and PyroDrogue/PyroMain fires from the RTT log).
    Verified PASS: Armed -> PoweredAscent -> drogue+main at apogee -> Landed, apogee 3295 m.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
2026-07-09 HIL/VLP: don't block the uplink loop during a manual pyro fire
    receive_vlp_task is the sole consumer of VLP uplinks (an embassy Signal that
    coalesces — un-taken values are overwritten). Its FirePyro branch played a 3-beep
    buzzer countdown with three `Timer::after_millis(1000).await` before firing, blocking
    the `vlp.receive()` loop for ~3s. Any uplinks arriving in that window were silently
    dropped. Over the air the ground station's per-uplink ack serialization hides this,
    but over the USB HIL transport (no ack) an operator/script sending commands close
    together loses all but the last.
    Reproduced on hardware: Armed, then `fire-pyro drogue` + `target-apogee 2777` +
    `mode self-test` back-to-b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
    [main.rs, receive_vlp_task.rs]
2026-07-10 Add hil-radio (Option B) HIL variant; enable self-test beeps; OPERATOR guide
    - hil-radio feature: fake sensors/pyro/GPS (HIL replay) but drive VLP over the
    REAL LoRa radio + GCM instead of the on-USB bridge, so the whole OPERATOR.md
    operator sequence can be flown over the air on the bench. Gates the real
    vlp_avionics_daemon_task on any(not(hil-replay), hil-radio) and the on-USB
    VLP bridge on all(hil-replay, not(hil-radio)); sensors/pyro/GPS/boot-mode
    stay HIL. Build: cargo run --bin main --features hil-single,hil-radio.
    Bench-validated: full plot flown over the radio (LowPower->Armed->ascent->
    apogee 3295 m->drogue+main->Landed), clean flight-log download.
    - Enable the self-te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
2026-07-10 HIL always uses the real radio; delete USB VLP bridge
    The real LoRa daemon and its VLP_KEY/LORA_CONFIG now compile and run in every
    build: flight and HIL both drive VLP over the real radio + GCM. Only the
    sensors, GPS, and pyro GPIO stay faked under `hil-replay` (boot still LowPower).
    - main.rs: un-gate vlp_avionics_daemon_task + its deps; drop the vlp_uplink_cmd
    channel and the VLP args to setup_usb_handler.
    - usb_handler.rs: delete the on-USB VLP bridge (VlpUplinkChannel, EP2 endpoint,
    vlp_downlink_drain/vlp_uplink_drain, the CliRequest::Uplink handler). USB now
    carries only flight-log traffic.
    - Cargo.toml: remove the now-redundant `hil-radio` feature (it is the default
    HIL behav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
2026-07-10 HIL: simulate only the barometer; run every other task for real
    HIL previously swapped out four things at once (IMU+baro, GPS, pyro GPIO, and
    the boot mode), so it exercised a path that diverged from flight. Now it fakes
    only the barometer reading -- the one sensor a static bench cannot exercise --
    and everything else runs the real production path:
    - imu_baro_task reads the real IMU, clocked by its real data-ready interrupt.
    A single seam, read_baro_or_sim, swaps the MS5607 read for the scripted
    trajectory. HIL never touches the real baro, so a bench baro fault cannot
    abort the simulated flight.
    - The real pyro_task (drives real GPIO) and real gps_task now run in HIL.
    - HIL boots into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
    [avionics_mode.rs, baro_sim.rs, data_logger.rs, main.rs, main_baro_bench.rs, mod.rs, sensor_tasks.rs]
2026-07-19 gps and armed mode fixes
    [armed_mode.rs, gps_task.rs]
2026-08-10 payload: collect sdrm stack status and epm rails for telemetry
    - read PayloadSDRMCustomStatus off the sdrm node status heartbeat
    - map CustomPayloadStatusMessage rails into the telemetry packet, keeping
    the 0xFFFF unavailable sentinel as None
    - drop rocket wifi / eps1 / eps2 node polling, self test checks, and the
    PayloadEPSOutputOverwrite uplink arm
    - rename payload activation pcb -> payload sdrm
2026-08-10 drop into_bootloader from reset messages
    Follows the removal of the custom bootloader in firmware-common-new.
    ResetMessage no longer carries the flag, so the three construction sites
    just lose the field. The lockfile drops salty/ed25519 along with it.
    [receive_vlp_task.rs]
2026-08-13 log kf altitude/velocity and flight stage in the fast record
    New KfStateWatch published per estimator sample in armed mode; data
    logger stamps it plus the per-sample flight stage into each fast record
    (storage v4, 73 B on wire, ~32 kB/s). Adds DATA_LOGGING.md mapping every
    value to radio telemetry / SD records and its post-flight derivability.
2026-08-13 wire mach lockout config, gate airbrakes during lockout
    MACH_LOCKOUT_DURATION_US is a 20 s placeholder — set from the flight sim
    (time above mach 0.75 x 1.4, ending >5 s before earliest apogee) before
    flight. None under hil-replay: the subsonic test-flight data's boost
    baro overshoot would spuriously trigger it. Findings doc: the simplified
    coast detector now requires the finding-6 stall fix to fly.
    [armed_mode.rs, main.rs]
2026-08-15 integrate airbrakes estimator v2 (phase C)
    Runs beside the slow deployment filter on the same IMU+baro stream, fed
    the sample's capture timestamp and the slow filter's speed as lockout-exit
    vote 2. Airbrakes gate additionally requires the estimator to trust the
    baro (2-of-3 vote or T_max); the MPC gets its altitude + 2D velocity and
    falls back to the slow filter's vertical-only state when the vertical
    filter is not running (which is also how HIL keeps working — the bench IMU
    never sees ignition). Telemetry tilt_deg is real for the first time; CAN
    rocket state carries the 2D velocity; the fast record logs both estimators
    plus the vote/clip flags (storage v5). AIRBRAKES_CONFIG per build flav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
2026-08-15 fix amp battery overwriting, change beacon test to battery 1
    [landed_mode.rs, self_test_mode.rs]
2026-08-16 estimator rework firmware side: one FlightEstimators mutex, honest telemetry, HIL IMU synthesis
    - armed_mode: single BlockingMutex<FlightEstimators>; airbrakes gate is
    airbrakes_mpc_states().is_some(); MPC future runs/stops on the same
    Option (no slow-filter fallback); both hil-replay overrides deleted
    - RocketState -> FlightStage mapped 1:1 (MachLockout and
    FailedToReachMinApogee reported honestly); coasting is a separate bool
    through FlightStageMutex, CAN, VLP telemetry and the fast record
    - HIL synthesizes IMU values at the sensor seam from the same script
    clock as the baro (exact per-phase specific force, hash noise, 0.1 deg/s
    injected gyro bias); real DRDY pacing kept; HIL.m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
    [armed_mode.rs, baro_sim.rs, can.rs, data_logger.rs, demo_mode.rs, imu_sim.rs, landed_mode.rs, low_power_mode.rs]
2026-08-16 data map v7 firmware side: new telemetry/record feeds, coasting off the wire
    - armed_mode telemetry: feed ab altitude/velocity/votes/born/apogee and
    target apogee; bulkhead blocks removed (BrightnessMeasurement CAN arm gone)
    - fast record: unix time from the GPS-disciplined clock, pyro flags snapshot,
    commanded/actual extension; slow record: Icarus servo temp + amp state via
    new AmpStateWatch CAN arm
    - FlightStageMutex back to plain FlightStage; RocketStateMessage 3-arg
    - LP/demo modes feed lat/lon into the low-power packet
    - DATA_LOGGING.md rewritten for the v7 map
2026-08-16 audit fixes: fill deployed telemetry bits, honest docs, wire cleanup follow-through
    - armed_mode: DrogueChute/MainChute arms now populate drogue/main_deployed
    (were silently false all flight); non-chute arms clear them
    - sd_card_writer emits STORAGE_VERSION in the USB download header
    - hil_operator.py waits on the current stage names (would hang on the old)
    - HIL.md / HIL_BENCH.md / VOID_LAKE_FINDINGS.md updated for the honest
    FlightStage; ESTIMATOR_REWORK_PLAN references inlined; altitude locals
    suffixed
    - can.rs: document the sacrificial empty pre-unix-time frame
    - DATA_LOGGING.md: drop the GPSBeaconPacket row
    [armed_mode.rs, baro_sim.rs, can.rs, data_logger.rs, hil_operator.py, main.rs, receive_vlp_task.rs, sd_card_writer.rs]
2026-08-16 payload can bus v2 firmware side: rail currents and actuator steps
    - armed_mode feeds the telemetry packet the new type 35 fields (battery mV,
    six rail currents, three actuator steps) instead of the four rail voltages
    - new PayloadStateWatch, fed from the CAN receive task the same way AmpStatus
    feeds AmpStateWatch, so the SD logger gets the payload readings too
    - data_logger writes them into the slow record raw, 0xFFFF sentinel and all
    - DATA_LOGGING.md: storage v8, slow record 73 B -> 97 B, telemetry packet
    36 B -> 43 B, and EPM rails move out of the "radio-only" row
2026-08-16 run flight-data logging inside armed mode
    The logger was a standalone task gating on `AvionicsMode::should_log()`,
    which is only a runtime re-derivation of "am I inside armed_mode". Making
    it one of armed mode's joined futures makes cross-session leakage
    unrepresentable instead of something to clean up after:
    * subscribers are created per session, and an embassy pubsub subscriber
    only receives messages published after its creation, so a re-arm
    (Armed -> LowPower -> Armed) can no longer carry pre-arm samples into
    the new session's first records — no low-power baro backlog, and no
    mag readings left over from the *previous* armed session (mag_task is
    powered down outsid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
    [armed_mode.rs, avionics_mode.rs, data_logger.rs, main.rs]
2026-08-16 tolerate transient bus errors on the IMU, baro, and mag
    A single SPI or I2C error ended imu_baro_task or mag_task permanently —
    no retry, no re-init. Losing imu_baro_task costs the estimators their
    input for the rest of the flight, so no apogee detection and no deploy,
    off one glitch. Nothing bounded the transfers in time either, so a
    stalled DMA parked the task forever, which watchdog_task cannot catch:
    it pets unconditionally and takes no liveness input from other tasks.
    Both tasks now follow the SD path's shape. Every transfer is bounded, and
    a sensor is only declared dead after SENSOR_IO_ERROR_LIMIT consecutive
    failures — a budget that any successful read restores in full.
    A failed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
    [sensor_tasks.rs]
2026-08-16 adopt the drag-based Mach lockout and the ab_vote_drag telemetry field
    Follows the air-brakes-controller-core change. AIRBRAKES_CONFIG loses
    baro_port_coefficient and gains subsonic_cda_over_mass, derived from
    ROCKET_PARAMETERS rather than configured so the lockout and the MPC cannot
    disagree about the airframe. The pre-flight TODO keeps only the two lockout
    timers, with one added constraint: t_min_us must now also sit after burnout,
    because the drag vote assumes free flight (thrust tail-off briefly cancels
    drag and reads as a false low speed).
    Telemetry and the fast-record ab_flags carry one drag-vote bit instead of
    three vote bits. DATA_LOGGING.md updated to match, including the packet's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
    [armed_mode.rs, data_logger.rs, main.rs]
2026-08-16 adopt the burnout latch, the inlined FLIGHT_CONFIG, and Ascent-only stages
    `FLIGHT_CONFIG` is now three fully-inline cfg-gated consts -- flight,
    hil-single, hil-dual -- instead of one const patched by cfg blocks and a
    shared `ROCKET_PARAMETERS`. Reading any one of them tells you the complete
    configuration that build flies, at the cost of writing the airframe three
    times; keep the three `rocket` copies in step, since the HIL benches exist
    to exercise the flight airframe.
    The MPC reads `FLIGHT_CONFIG.airbrakes.rocket`, the same field the
    estimator's drag vote inverts, so within a build the two provably cannot
    disagree about the vehicle.
    `FlightStage::MachLockout` is gone: the deployment esti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
    [armed_mode.rs, data_logger.rs, main.rs]
2026-08-16 airbrakes validation deploy near apogee, follow the estimator API changes
    If the MPC never asks for full extension the whole way up — what an
    undershoot looks like — force 100% once vertical velocity drops below
    Mach 0.1, so every flight ends with in-flight evidence the brakes actuate.
    Threshold is on vertical velocity, matching the gate's own MAX_OPEN_MACH:
    the gate only runs while it is positive, so it necessarily sweeps through
    before apogee, where total airspeed would not on a tilted flight. Full
    extension costs ~0.1 m/s^2 that slow. Closes the TODO line.
    Follow the core crate: airbrakes_estimator() is an Option now, so the
    telemetry and SD paths report absent from retirement onward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
2026-08-16 sample estimator state at the tick it belongs to, log airbrakes at 10 Hz
    The estimator loop and the logger both used next_message_pure(), which
    silently discards WaitResult::Lagged(n). That is materially dangerous for
    the deployment estimator: its timers are counts of samples and its KF
    integrates a fixed DT, so dropped samples stretch pyro timing without a
    trace. Both now handle Lagged explicitly -- the logger folds the count
    into `sequence` so the gap is visible in the log -- and the IMU/baro
    pubsub goes from 10 to 256 deep (~615 ms at 416 Hz, ~14 kB).
    The estimator loop reads its outputs inside the same lock as the update
    and publishes them stamped with that sample's timestamp; the logge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
    [armed_mode.rs, data_logger.rs, demo_mode.rs, sensor_tasks.rs]
2026-08-16 report igniter continuity on power-on, log every node's full status
    The power-on burst gains two notes after the fixed low/mid/high: two highs
    if both pyro channels have continuity, two lows otherwise. It waits for
    pyro_task's first reading rather than assuming one -- the task enables the
    pyro supply and waits 10ms before it can measure -- but boot must not hang
    on it, so the wait is bounded at 500ms and a timeout counts as "not good",
    which is the honest answer when continuity cannot be read at all. The
    receiver is scoped so it releases its slot; ContinuityWatch only has two.
    The third note carries 500ms of silence instead of the usual 100 so the
    fixed burst and the continuity report do not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
    [armed_mode.rs, data_logger.rs, main.rs, self_test_mode.rs]
2026-08-16 read absence from the estimators instead of inventing zeros
    Follows firmware-common-new's move from sentinel values to Option. The
    watch payloads that only ever live in RAM -- AirBrakesLogState,
    PayloadLogState, AmpLogState -- carried NaN and 0xFFFF for no reason; they
    now carry Option and the SD record is built straight from it.
    AmpLogState's Default was an outright bug: an empty watch collapsed to
    (0.0, 0), and 0 is a valid PowerOutputStatus discriminant, so "AMP has never
    spoken" logged as three genuine output statuses. It is now None.
    armed_mode's packet fill dropped from 87 lines to 47. The seven-arm match on
    RocketState is gone: deployment_kf comes from kf_altitude_asl() and
    kf_verti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
    [armed_mode.rs, can.rs, data_logger.rs, demo_mode.rs, landed_mode.rs]
2026-08-17 prune the TODOs that landed, keep the one the sims raised
    The airbrakes_flags bitmask, UnixClock and TelemetryPacket entries are all
    resolved; the CAN bus filter note is hardware's, not firmware's.
    "1s between ignition and supersonic?" stays: the Osiris replays put the
    airframe through Mach 1 about a second after ignition, which is worth
    knowing precisely.
2026-08-17 fly the real config on the bench, and measure the IMU
    hil-dual replays the actual Osiris OpenRocket trajectory against the real
    FLIGHT_CONFIG rather than a softened bench profile — a bench profile with
    its own numbers would only prove the bench profile works — and implies
    boot-armed so the bench needs no ground station. boot-armed cannot reach
    a flight build (compile_error in main.rs): the pyro task drives real
    GPIO, so an unattended Armed boot energizes both channels about a minute
    in, on every reset.
    Adds the imu_bench binary and its stats script, which is where the
    427.02 Hz measured ODR came from, and the per-profile
    ignition_detection_acc_threshold — 8 g for Osiris, whose boost h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
    [imu_sim.rs, main.rs, main_imu_bench.rs, mod.rs, osiris.rs]
2026-08-17 report the pad calibration in the log and the downlink
    Sets AIRBRAKES_PAD_CALIBRATED in the fast record and
    packet.airbrakes_calibrated in the telemetry packet. It is the only
    airbrakes bit either channel carries before ignition, and so the only one
    that can still be acted on: ignition detection is gated on the
    calibration, so a rocket on the rail reporting false will fly with no
    airbrakes and report nothing else unusual while doing it.
    Also refreshes the estimator-loop lag comment and its warning. A dropped
    sample no longer stretches the Mach lockout, the pyro delays or the
    apogee/landing persistence — those read the sample timestamp now — it
    only costs the deployment KF that many fixe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
    [armed_mode.rs, data_logger.rs]
2026-08-17 fly one Mach number, and drop the TODO it answers
    Tracks air-brakes-controller-core collapsing SUBSONIC_MACH and
    MAX_OPEN_MACH into one per-airframe AirbrakesConfig::max_open_mach.
    FLIGHT_CONFIG now carries 0.8 where it carried a 0.8 exit and a 0.85
    ceiling. The comment records what the number means -- the Mach FDR Table 10
    tabulates the Cd at, which is also the speed below which the flaps may open
    -- and that measured birth lands at Mach 0.726 nominal, 0.743 with a
    5x-wrong Cd, so the gate stays slack without a second constant.
    earliest_subsonic_after_ignition_us gets the note that it, not the ceiling,
    is the guard doing the work: it holds the drag check shut until 17.5 s,
    0.06 s ahead of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
    [armed_mode.rs, main.rs]
2026-08-17 drop a NaN baro read, and stop one closed gate ending airbrakes
    Two firmware defects from the estimator audit, plus the call-site
    changes for the core crate's new shapes.
    A NaN barometer altitude silently ended the flight. Both baro gates in
    the deployment estimator test .abs() > threshold, which is false for
    NaN, so a NaN took the accept branch and was fused into the filter that
    fires the pyros: replayed against Void Lake, 3 ms of it took the run
    from 41915 state changes ending Landed with both pyros, to 175 ending
    in Ascent with a NaN vertical velocity and no pyros at all. No panic,
    no reset, nothing in the log to say why. It is reachable from the
    driver -- ms5607.rs's integer compensatio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
    [armed_mode.rs, data_logger.rs, main.rs, sensor_tasks.rs]
2026-08-17 make AMP outputs reflect this years circuit layout
2026-08-17 keep the HIL facts the source cannot carry, drop the rest
    HIL.md and HIL_BENCH.md had drifted into contradicting each other and the
    code. Both still claimed HIL fakes only the barometer, which stopped being
    true when imu_sim landed. HIL.md's feature table put hil-single at 2.9 km
    and 1.5 min against baro_sim's own constants (3296 m, ~176 s) and against
    two other passages in the same file; its noise paragraph still cited the
    pre-imu_bench scalars that imu_sim.rs calls 2-5x pessimistic; everything
    below "What is simulated" described only the analytic script, so the Dual
    column of the timings table printed single-deploy numbers.
    Worst of it: the two files named different probes for the VLF5. H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
    [mod.rs, sensor_tasks.rs]
2026-08-17 follow the flag renumber, and stop documenting a reserved bit
    The airbrakes flag byte no longer holds bit 4 empty for the retired
    AIRBRAKES_APOGEE latch, and the log format is v13. The writer needed no code
    change - every flag is applied by name, none by numeral - so this is the
    comment and the doc catching up.
    DATA_LOGGING.md was stale in both directions: it listed an apogee latch that
    no longer exists, and omitted airbrakes_pad_calibrated, which is logged. It
    also claimed pad calibration was recorded nowhere; it is on the fast record,
    just not on any wire. Both corrected.
    [data_logger.rs]
2026-08-17 build the flight firmware for speed, and log what the MPC aims at
    opt-level was "z". On the board that cost 2.2x on the airbrakes MPC solve —
    18.5 ms against 8.3 ms for the same source — and flash was never the
    binding constraint: 403 KB of a 1984 KB budget. rustc enables neither
    fast-math nor FP contraction at any opt-level, so every float result is
    bit-identical to the size build; this is pure scheduling and inlining.
    Together with the density and sqrt changes in the monorepo, the worst-case
    solve at the Mach-0.8 gate ceiling goes 18.5 ms -> 1.11 ms. Re-flown on
    hil-dual afterwards, the airbrakes window stopped being visible in the
    executor at all:
    worst sample age 21.3 ms -> 1.1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
    [armed_mode.rs, data_logger.rs]
2026-08-17 catch a dead sensor instead of flying on its last reading
    The driver already knew how to detect a missing part and threw the answer
    away. `LSM6DSM::reset` and `LIS2MDL::reset` return `Ok(false)` on a wrong
    WHO_AM_I, and all three call sites discarded the bool. SPI has no ACK, so
    an absent part reads back as a clean transfer, `power_up` is writes-only,
    and the loop then parks forever on a DRDY edge that never comes. No error
    is ever produced, so the five-failure budget never trips, `imu_ok` and
    `baro_ok` stay true, and self test plays the success chime. In armed mode
    that same park stops the estimator loop, which is where the pyro fire path
    lives -- the hazard `sensor_tasks` already documents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
    [armed_mode.rs, can.rs, can_central.rs, data_logger.rs, demo_mode.rs, landed_mode.rs, lis2mdl.rs, low_power_mode.rs]
2026-08-17 downlink the payload's own battery while waiting on the pad
    Low power is where the rocket sits for the hours before launch, so it is where
    the payload stack's EPM battery matters most — and it was the one mode that
    could not report it. Both LowPower and Demo now relay it from
    CustomPayloadStatus onto the low-power packet, which grew two bytes to carry
    it.
    Each mode gets its own payload StatusStreamReceipt. Nothing but the CAN arm
    writes epm_batt_mv, so without one a payload that browned out mid-wait would
    keep downlinking the healthy voltage it had when it stopped talking — for as
    long as the mode lasts, which in low power is until an operator says otherwise.
    The message accessor alrea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
2026-08-17 give the drag check the altitude it crosses Mach 0.8 at
    Follows the core crate: the lockout-exit drag check no longer takes air
    density from the dead-reckoned altitude, so the flight config has to say where
    this airframe is when it crosses `max_open_mach`.
    6800 m is the O3400's 6734 m crossing from the same sim the two timers above
    it come from, rounded up. Up is the safe direction -- higher altitude reads
    density low and the inverted airspeed high, which only ever delays the exit --
    and it is also what covers the backup motor: the N2900 crosses 1151 m lower,
    so on that motor the check votes at Mach 0.736 instead of 0.796, still under
    the configured 0.800. Both are asserted per-simulation b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
    [main.rs]
2026-08-18 log every altitude ASL, and the pad it is measured from
    The SD log was already ASL everywhere except two airbrakes columns, and it
    never stored the launch pad altitude at all — so the AGL numbers the flight
    actually acted on could not be reproduced from the card. `launch_pad_altitude_asl`
    joins the slow record, taken from the same estimator sample as the fast
    record's altitudes so the reference and the readings cannot describe different
    pads; the two apogee columns become ASL.
    The MPC's target is now published by the control loop when it builds the MPC,
    instead of the logger resampling `target_agl_watch` per record. The MPC takes
    its target once, so a SetTargetApogee accepted later moved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
2026-08-18 set the brakes-permitted bit on every fast record
    The MPC's own gate, at 427 Hz rather than at the 10 Hz the control loop
    runs at — this is the only column that dates the permission to the
    sample it was decided on instead of to the next control tick.
    Free in bytes: AIRBRAKES_MPC_PERMITTED is a spare bit of the airbrakes
    flags byte that was already on the record.
2026-08-18 one airbrakes-enabled bit, where there were two
    The estimator's `baro_trusted` and `mpc_permitted` are the same fact now
    that the Mach limit is a transition condition rather than a per-sample
    gate, so the logger sets one flag and the downlink's `airbrakes_born`
    reads the one accessor.
2026-08-18 put the brake command and actual extension on the fast record
    The watch was already sampled once per fast record; only the record it
    was written into was slow. Icarus's reports now arrive at 100 Hz, so the
    Icarus-sourced half is fresh enough to be worth timestamping properly.
2026-08-18 stop hil-dual from implying boot-armed
    A dual-deploy HIL run now boots into SelfTest like a flight build and is
    armed from rocket-cli; a bench with no ground station adds boot-armed
    explicitly. Both the feature's own comment and the pyro safety callout in
    HIL2.md described the implication, so both move with it.
2026-08-18 stop packing the airbrakes gate bits, which no longer exist
    The airbrakes filter fuses every baro sample now, so there is no outcome
    to pack. Its flag byte is three flags and the two-bit state, from bit 0
    with no hole.
    [data_logger.rs]
2026-08-18 raise the subsonic floor to 17.70 s, now that nothing follows it
    The drag check no longer holds for a second before it concludes, so this
    timer is the whole of the timing guarantee against an early lockout exit.
    The O3400 crosses Mach 0.8 at 17.56 s and the old 17.50 s floor cleared
    that only with the sustain's help. It costs no control window: the check
    has never voted before 17.72 s on this motor.
    [main.rs]
2026-08-18 stop packing the drag-check bit, which can no longer say anything
    Nothing defers the check's vote now, so the vote and the birth are one
    row and the birth is already logged as the airbrakes state. The flag byte
    is two flags and the two-bit state, from bit 0.
    [data_logger.rs]
2026-08-18 log the payload's load cells and experiment flags
    The receive handler decodes the load cells through the message's accessors,
    the way it already does the rails and actuators, so the payload's INT16_MIN
    "SEM did not report this channel" stops at the bus boundary.
    The flag word stays packed all the way to the card. Unpacking it here would
    mean carrying 21 bools through the watch and repacking them for the log,
    with two more chances to get the layout wrong; rocket-cli decodes it once.
    [can.rs, data_logger.rs]
2026-08-18 the packet has four spare bits, not five
    Counted the declared fields rather than trusting the note: 300 bits of 304.
    The distinction matters now that there is something waiting to spend them —
    three arm-sequence bits fit, and a fourth field does not.
2026-08-18 put the payload's experiment flags on the downlink
    The packet takes five of the seven per-channel flags; which five is the
    packet's business, so the handler passes all seven and lets it choose. The
    stale clear zeroes them, because they have no absence encoding and a
    fracture the payload can no longer confirm should stop being asserted.
    DATA_LOGGING gets the corrected time-on-air table: SF12/250kHz/CR4-8 with
    CRC off and LDRO on puts 38..41B in one bucket at 1642.5ms, which is 82%
    of the 2s telemetry period, and each step up costs 131.1ms.
    [armed_mode.rs]
2026-08-18 relay the payload's load cells to the downlink
    Centinewtons straight off the CAN accessors; the packet does the newton
    conversion and the quantizing. The stale clear blanks them with the rest
    of the payload readings.
